kevin-nixie/mfd_thermostat/reptistat.step

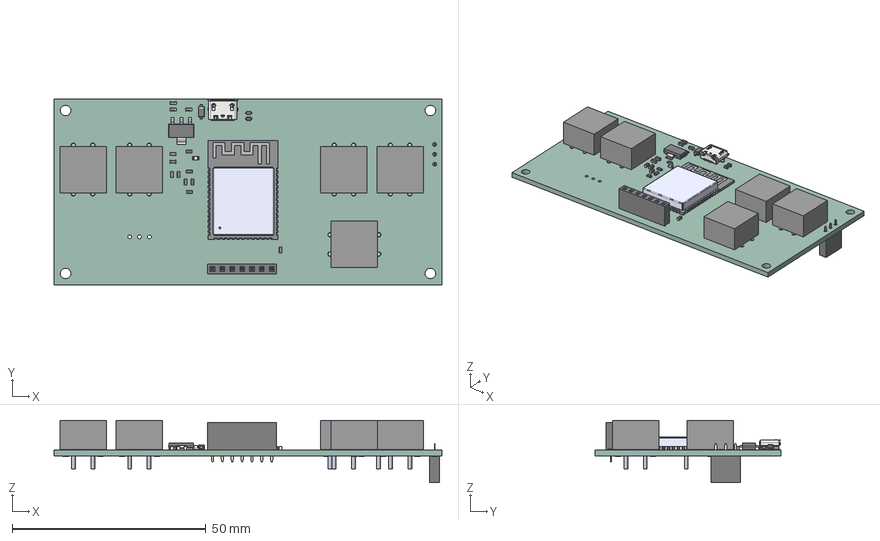
[picture p1: CAD file, 2025-11-16]
reptistat.step
100.0 x 48.0 x 16.1 mm
C_0603_1608Metric x 9
SOT_223
ASSEMBLY x 5
D_SOD_123
USB_Micro-B_Molex_47346-0001
PinSocket_1x03_P254mm_Vertical
ESP32-S3-WROOM-1-N4
PinSocket_1x07_P254mm_Vertical
D_SOD_523 x 2
R_0603_1608Metric x 4
LED_0603_1608Metric
_autosave-reptistat_PCB
