kevin-nixie/mfd_thermostat/reptistatv2a.step

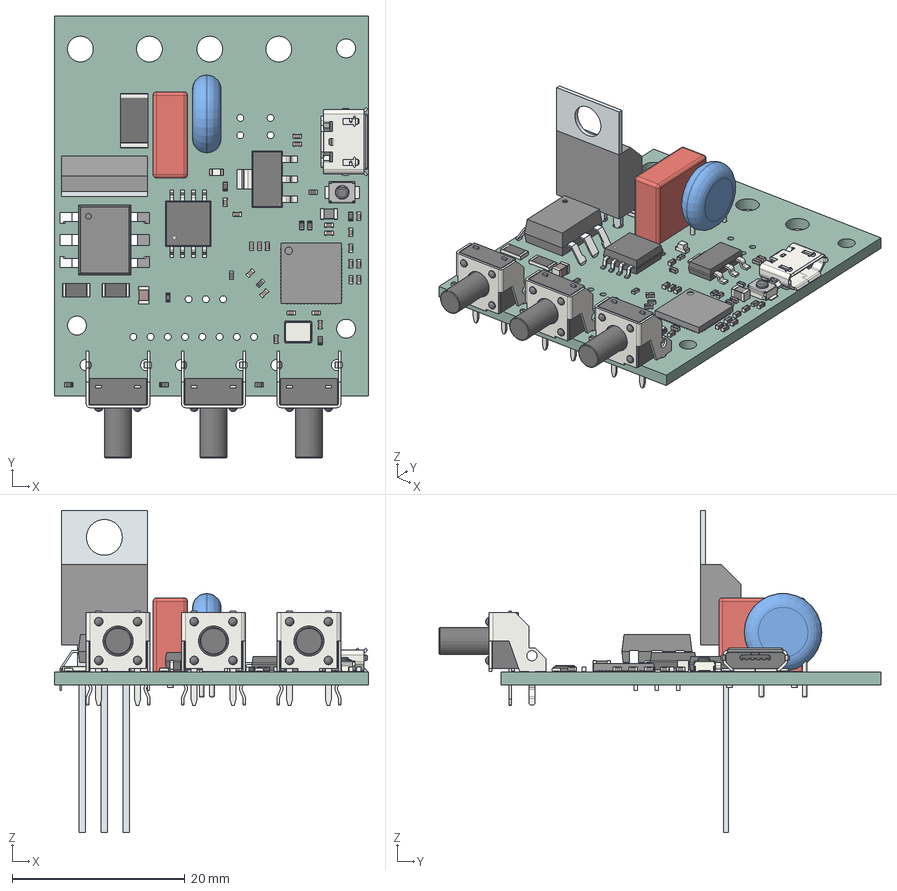
[picture p2: CAD file, 2025-11-16]
reptistatv2a.step
36.4 x 51.2 x 37.3 mm
L_0805_2012Metric
SOT-223
C_0402_1005Metric x 22
RV_Disc_D9mm_W3.3mm_P5mm
Crystal_SMD_Abracon_ABM8G-4Pin_3.2x2.5mm
R_2512_6332Metric
R_0402_1005Metric x 12
C_Rect_L10.0mm_W4.0mm_P7.50mm_FKS3_FKP3
USB_Micro-B_Molex_47346-0001
SW_Tactile_SPST_Angled_PTS645Vx83-2LFS x 3
Tab
PinsArray
SW_SPST_B3U-1000P
MOC3021SM
R_1206_3216Metric x 2
LED_0603_1608Metric
SOIC-8_5.3x5.3mm_P1.27mm
C_0805_2012Metric
ThermalPin
PinsArrayLR
PinsArrayTB
reptistat_PCB
