kevin-nixie/mfd_thermostat/reptistatV2a v1.step

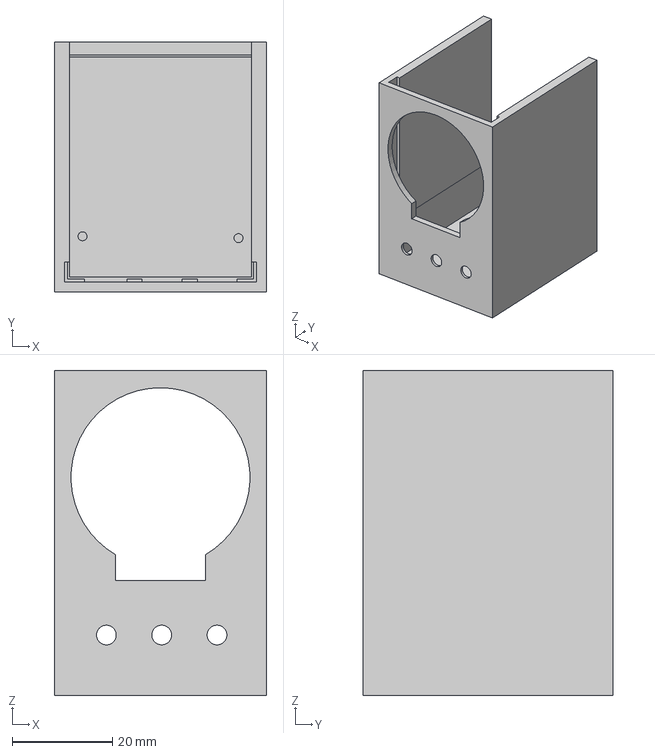
[picture p3: CAD file, 2025-11-16]
reptistatV2a v1.step
42.4 x 50.0 x 65.0 mm
