kevin-nixie/mfd_thermostat/VREG.kicad_sch

## KiCad design VREG.kicad_sch (2025-11-16)

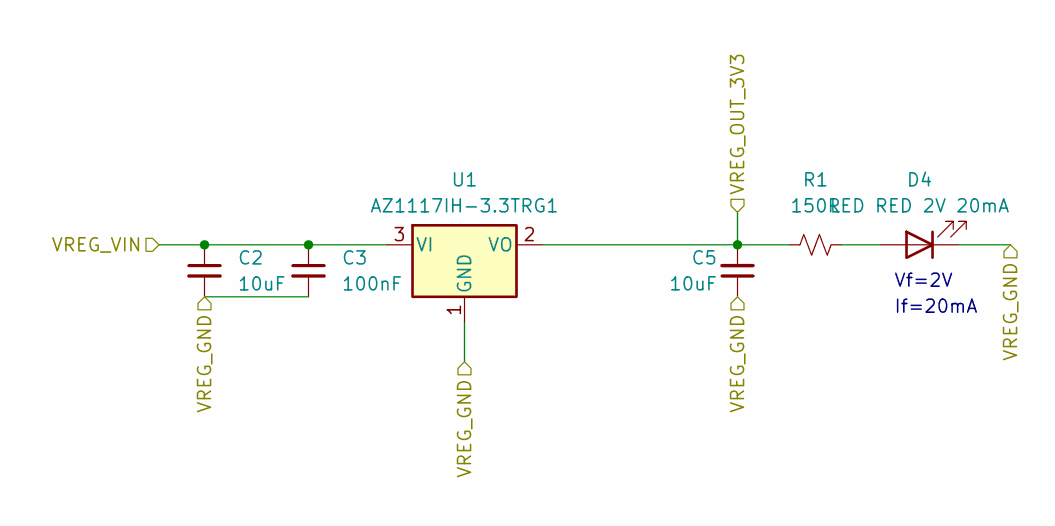
[picture p4: schematic VREG.kicad_sch]

Parts:
C2, C5: 10uF; C_0402_1005Metric; JLCPCB Part# C15525
C3: 100nF; C_0402_1005Metric; JLCPCB Part# C1525
D4: LED RED 2V 20mA; LED_0603_1608Metric; JLCPCB Part# C2286
R1: 150R; R_0402_1005Metric; JLCPCB Part# C25082
U1: AZ1117IH-3.3TRG1; SOT-223-3_TabPin2; JLCPCB Part# C108495

Connections:
unnamed: D4.2 (A), R1.2
VREG_GND: C2.2, C3.2, C5.1, D4.1 (K), U1.1 (GND)
VREG_OUT_3V3: C5.2, R1.1, U1.2 (VO)
VREG_VIN: C2.1, C3.1, U1.3 (VI)

Notes on the sheet:
Vf=2V
If=20mA
