kevin-nixie/mfd_thermostat/acdc.kicad_sch

## KiCad design acdc.kicad_sch (2025-11-16)

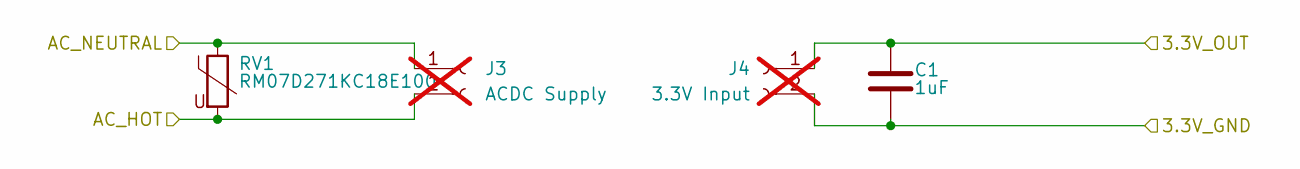
[picture p5: schematic acdc.kicad_sch]

Parts:
C1: 1uF; C_0402_1005Metric; JLCPCB Part# C52923
J3: ACDC Supply; PinHeader_1x02_P2.00mm_Vertical; not fitted
J4: 3.3V Input; PinHeader_1x02_P2.00mm_Vertical; not fitted
RV1: RM07D271KC18E100; RV_Disc_D9mm_W3.3mm_P5mm; JLCPCB Part# C2974821

Connections:
3.3V_GND: C1.2, J4.2
3.3V_OUT: C1.1, J4.1
AC_HOT: J3.2, RV1.2
AC_NEUTRAL: J3.1, RV1.1
