kevin-nixie/mfd_thermostat/connectors.kicad_sch

## KiCad design connectors.kicad_sch (2025-11-16)

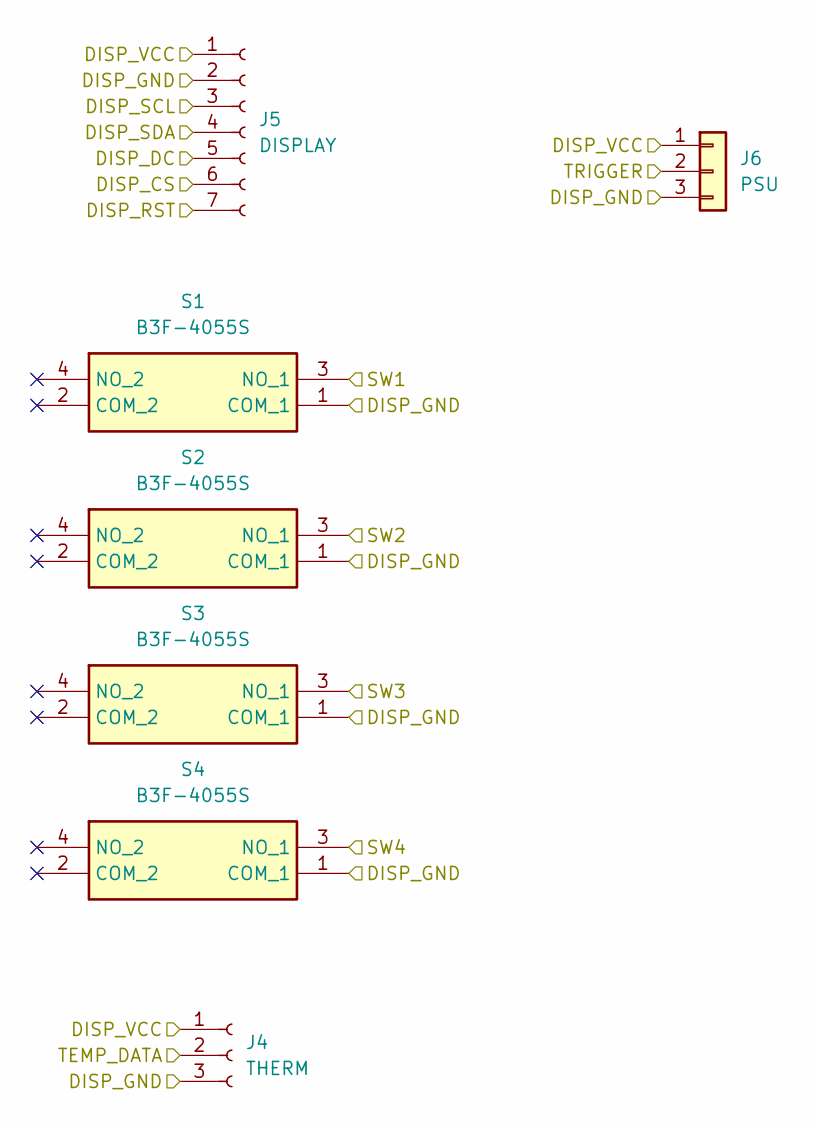
[picture p6: schematic connectors.kicad_sch]

Parts:
J4: THERM; PinHeader_1x03_P2.54mm_Vertical
J5: DISPLAY; PinHeader_1x07_P2.54mm_Vertical
J6: PSU; PinSocket_1x03_P2.54mm_Vertical
S1, S2, S3, S4: B3F-4055S; B3F4055S; Mouser Part Number 653-B3F-4055S

Connections:
DISP_CS: J5.6
DISP_DC: J5.5
DISP_GND: J4.3, J5.2, J6.3, S1.1 (COM_1), S2.1 (COM_1), S3.1 (COM_1), S4.1 (COM_1)
DISP_RST: J5.7
DISP_SCL: J5.3
DISP_SDA: J5.4
DISP_VCC: J4.1, J5.1, J6.1
SW1: S1.3 (NO_1)
SW2: S2.3 (NO_1)
SW3: S3.3 (NO_1)
SW4: S4.3 (NO_1)
TEMP_DATA: J4.2
TRIGGER: J6.2
