kevin-nixie/mfd_thermostat/mcu.kicad_sch

## KiCad design mcu.kicad_sch (2025-11-16)

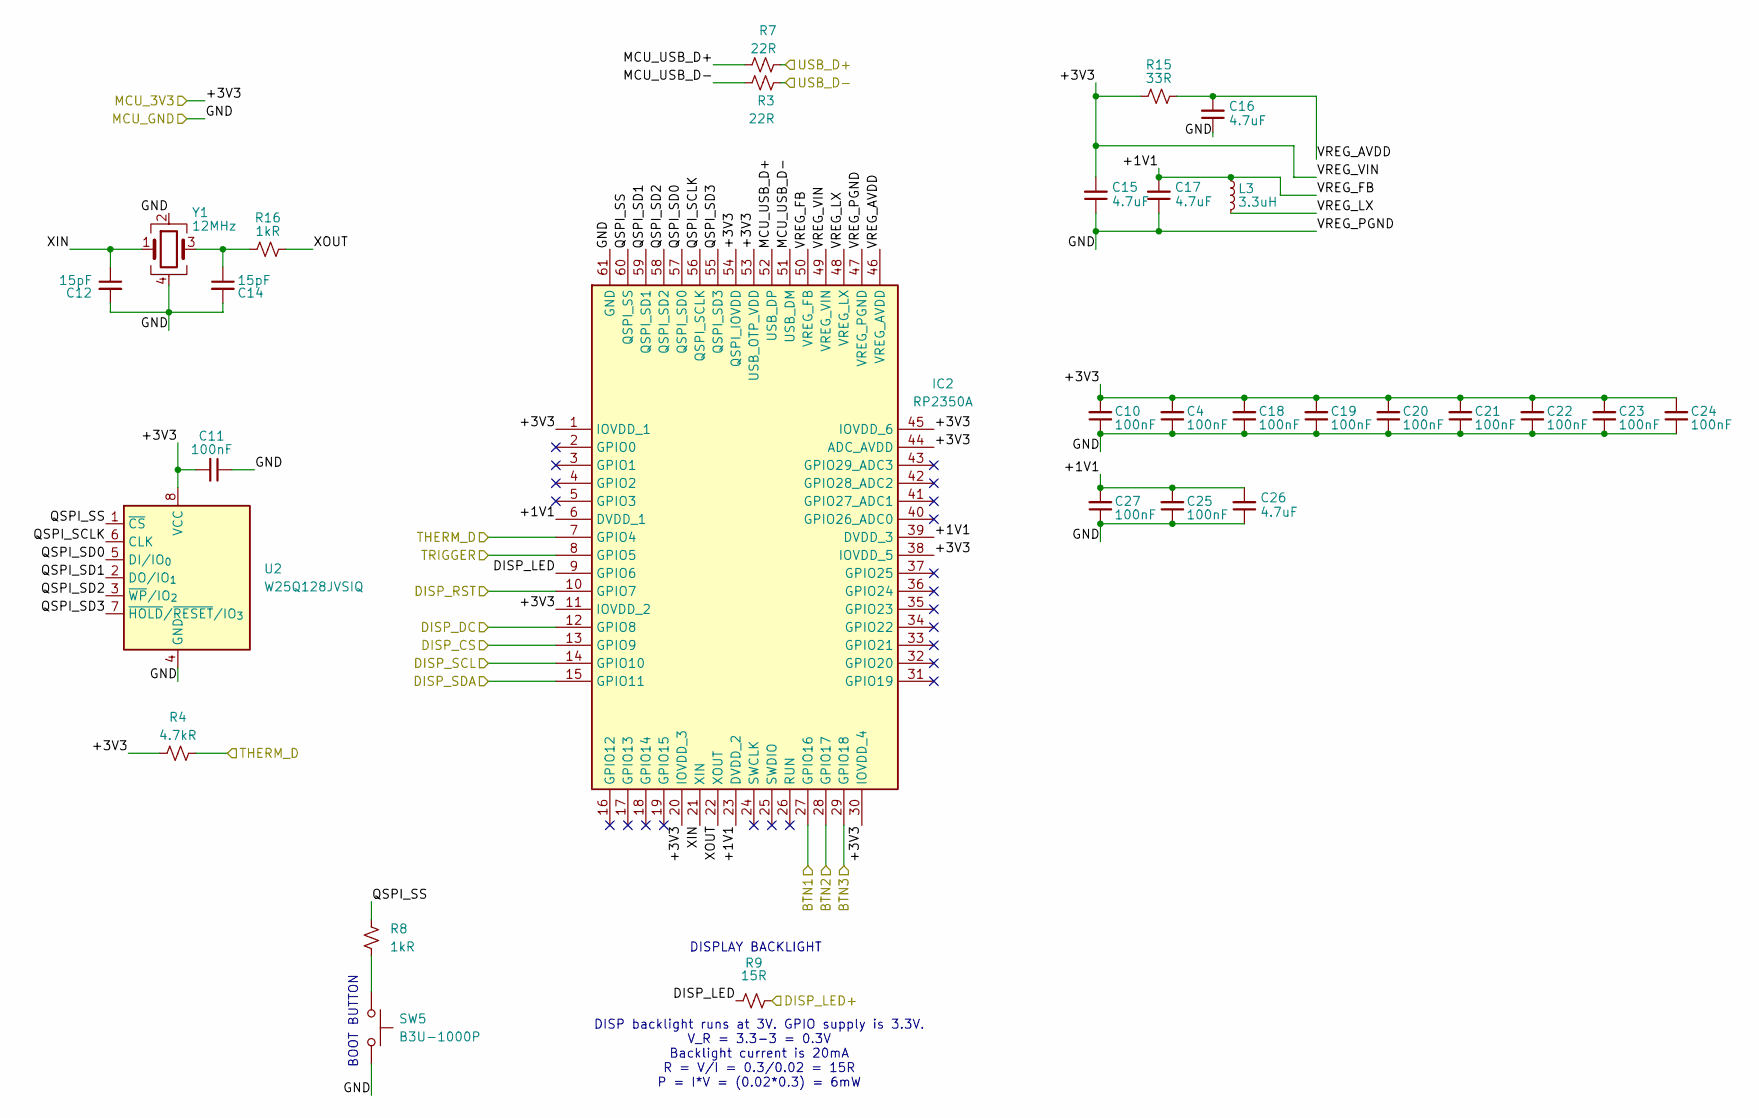
[picture p7: schematic mcu.kicad_sch]

Parts:
C4, C10, C11, C18, C19, C20, C21, C22, C23, C24, C25, C27: 100nF; C_0402_1005Metric; JLCPCB Part# C1525
C12, C14: 15pF; C_0402_1005Metric; JLCPCB Part# C1548
C15, C16, C17, C26: 4.7uF; C_0402_1005Metric; JLCPCB Part# C23733
IC2: RP2350A; JLCPCB Part# C42411118
L3: 3.3uH; L_0805_2012Metric; JLCPCB Part# C42411119
R3, R7: 22R; R_0402_1005Metric; JLCPCB Part# C25092
R4: 4.7kR; R_0402_1005Metric; JLCPCB Part# C25900
R8, R16: 1kR; R_0402_1005Metric; JLCPCB Part# C11702
R9: 15R; R_0402_1005Metric; JLCPCB Part# C25083
R15: 33R; R_0402_1005Metric; JLCPCB Part# C25105
SW5: B3U-1000P; SW_SPST_B3U-1000P; JLCPCB Part# C231329
U2: W25Q128JVSIQ; SOIC-8_5.3x5.3mm_P1.27mm; JLCPCB Part# C97521
Y1: 12MHz; Crystal_SMD_Abracon_ABM8G-4Pin_3.2x2.5mm; JLCPCB Part# C20625731

Connections:
+1V1: C17.2, C25.2, C26.2, C27.2, IC2.6 (DVDD_1), IC2.23 (DVDD_2), IC2.39 (DVDD_3), IC2.50 (VREG_FB), L3.1
+3V3: C4.2, C10.2, C11.2, C15.2, C18.2, C19.2, C20.2, C21.2, C22.2, C23.2, C24.2, IC2.1 (IOVDD_1), IC2.11 (IOVDD_2), IC2.20 (IOVDD_3), IC2.30 (IOVDD_4), IC2.38 (IOVDD_5), IC2.44 (ADC_AVDD), IC2.45 (IOVDD_6), IC2.49 (VREG_VIN), IC2.53 (USB_OTP_VDD), IC2.54 (QSPI_IOVDD), R4.1, R15.1, U2.8 (VCC)
BTN1: IC2.27 (GPIO16)
BTN2: IC2.28 (GPIO17)
BTN3: IC2.29 (GPIO18)
DISP_CS: IC2.13 (GPIO9)
DISP_DC: IC2.12 (GPIO8)
DISP_LED: IC2.9 (GPIO6), R9.2
DISP_LED+: R9.1
DISP_RST: IC2.10 (GPIO7)
DISP_SCL: IC2.14 (GPIO10)
DISP_SDA: IC2.15 (GPIO11)
GND: C4.1, C10.1, C11.1, C12.2, C14.2, C15.1, C16.1, C17.1, C18.1, C19.1, C20.1, C21.1, C22.1, C23.1, C24.1, C25.1, C26.1, C27.1, IC2.47 (VREG_PGND), IC2.61 (GND), SW5.2, U2.4 (GND), Y1.2, Y1.4
MCU_USB_D+: IC2.52 (USB_DP), R7.2
MCU_USB_D-: IC2.51 (USB_DM), R3.2
unnamed: C14.1, R16.1, Y1.3
unnamed: R8.2, SW5.1
QSPI_SCLK: IC2.56 (QSPI_SCLK), U2.6 (CLK)
QSPI_SD0: IC2.57 (QSPI_SD0), U2.5 (DI/IO_{0})
QSPI_SD1: IC2.59 (QSPI_SD1), U2.2 (DO/IO_{1})
QSPI_SD2: IC2.58 (QSPI_SD2), U2.3 (~WP/IO_{2})
QSPI_SD3: IC2.55 (QSPI_SD3), U2.7 (~HOLD/~RESET/IO_{3})
QSPI_SS: IC2.60 (QSPI_SS), R8.1, U2.1 (~CS)
THERM_D: IC2.7 (GPIO4), R4.2
TRIGGER: IC2.8 (GPIO5)
USB_D+: R7.1
USB_D-: R3.1
VREG_AVDD: C16.2, IC2.46 (VREG_AVDD), R15.2
VREG_LX: IC2.48 (VREG_LX), L3.2
XIN: C12.1, IC2.21 (XIN), Y1.1
XOUT: IC2.22 (XOUT), R16.2

Notes on the sheet:
DISP backlight runs at 3V. GPIO supply is 3.3V. V_R = 3.3-3 = 0.3V Backlight current is 20mA R = V/I = 0.3/0.02 = 15R P = I*V = (0.02*0.3) = 6mW
BOOT BUTTON
DISPLAY BACKLIGHT
