kevin-nixie/mfd_thermostat/reptistat.kicad_sch

## KiCad design reptistat.kicad_sch (2025-11-16)

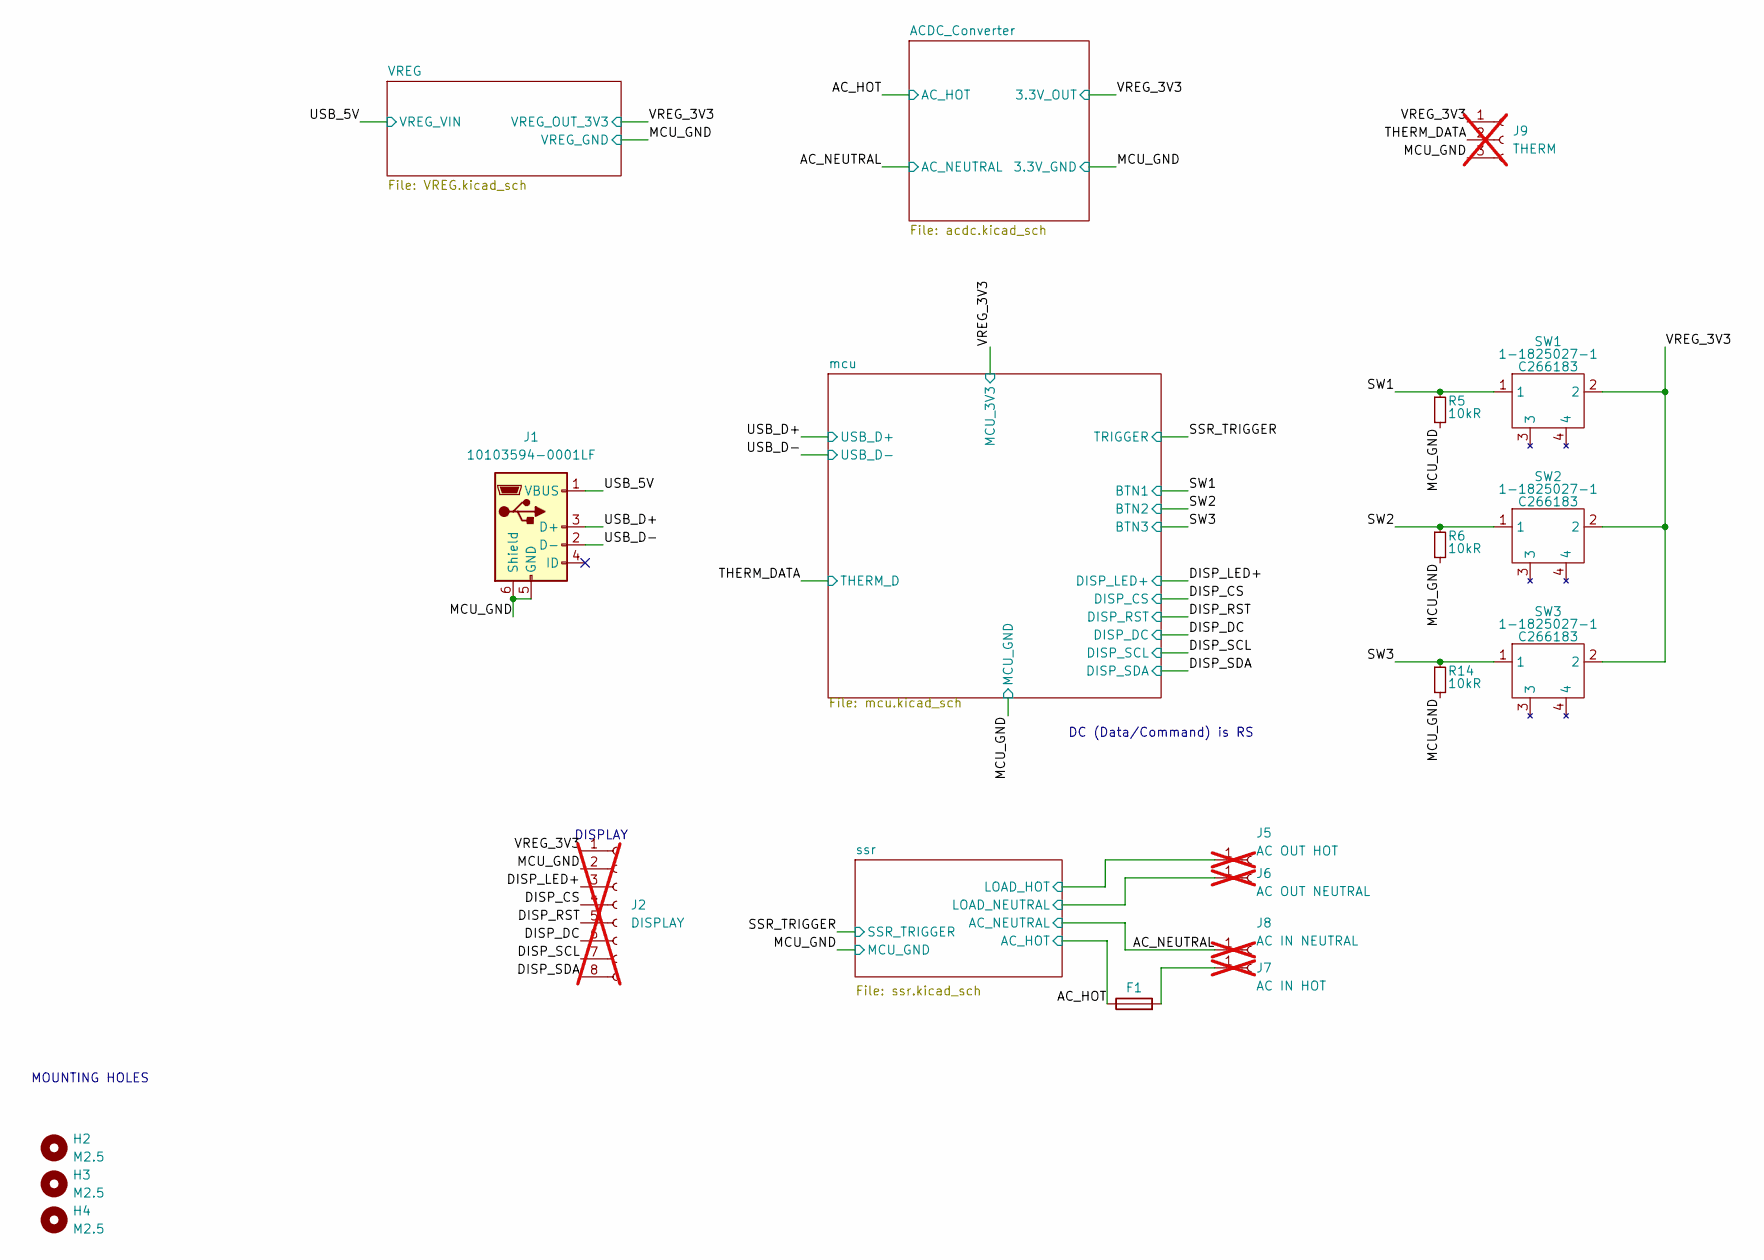
[picture p8: schematic reptistat.kicad_sch]

Parts:
F1: 3A 125V Nano2 451 Fuse; Fuse_Littelfuse-NANO2-451_453; JLCPCB Part# C13982
H2, H3, H4: M2.5; MountingHole_2.2mm_M2
J1: 10103594-0001LF; USB_Micro-B_Amphenol_10103594-0001LF_Horizontal; JLCPCB Part# C428495
J2: DISPLAY; PinHeader_1x08_P2.00mm_Vertical; not fitted
J5: AC OUT HOT; TestPoint_Plated_Hole_D3.0mm; not fitted
J6: AC OUT NEUTRAL; TestPoint_Plated_Hole_D3.0mm; not fitted
J7: AC IN HOT; TestPoint_Plated_Hole_D3.0mm; not fitted
J8: AC IN NEUTRAL; TestPoint_Plated_Hole_D3.0mm; not fitted
J9: THERM; PinHeader_1x03_P2.00mm_Vertical; not fitted
R5, R6, R14: 10kR; R_0402_1005Metric; JLCPCB Part# C25744
SW1, SW2, SW3: 1-1825027-1; JLCPCB Part# C266183

Connections:
AC_HOT: F1.1
AC_NEUTRAL: J8.1
DISP_CS: J2.4
DISP_DC: J2.6
DISP_LED+: J2.3
DISP_RST: J2.5
DISP_SCL: J2.7
DISP_SDA: J2.8
LOAD_HOT: J5.1
LOAD_NEUTRAL: J6.1
MCU_GND: J1.5 (GND), J1.6 (Shield), J2.2, J9.3, R5.2, R6.2, R14.2
unnamed: F1.2, J7.1
SW1: R5.1, SW1.1
SW2: R6.1, SW2.1
SW3: R14.1, SW3.1
THERM_DATA: J9.2
USB_5V: J1.1 (VBUS)
USB_D+: J1.3 (D+)
USB_D-: J1.2 (D-)
VREG_3V3: J2.1, J9.1, SW1.2, SW2.2, SW3.2

Notes on the sheet:
MOUNTING HOLES
DISPLAY
DC (Data/Command) is RS
