kevin-nixie/mfd_thermostat/ssr.kicad_sch

## KiCad design ssr.kicad_sch (2025-11-16)

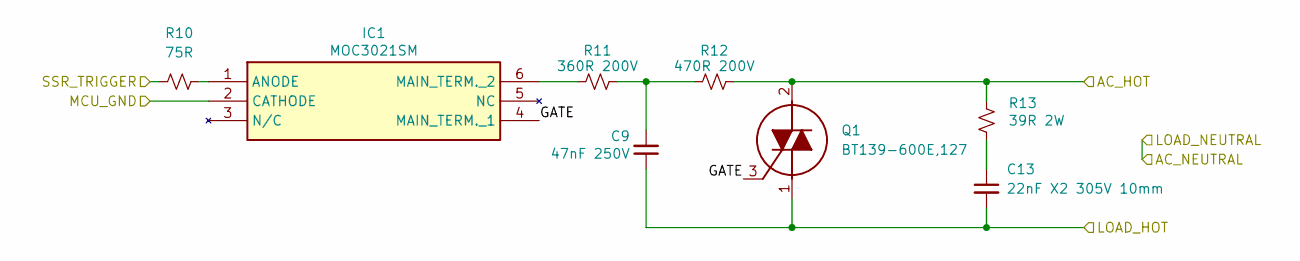
[picture p9: schematic ssr.kicad_sch]

Parts:
C9: 47nF 250V; C_0805_2012Metric; JLCPCB Part# C7393958
C13: 22nF X2 305V 10mm; C_Rect_L10.0mm_W4.0mm_P7.50mm_FKS3_FKP3; JLCPCB Part# C2693739
IC1: MOC3021SM; SOP254P916X480-6N; JLCPCB Part# C108500
Q1: BT139-600E,127; TO254P470X1000X2000-3P; JLCPCB Part# C389357
R10: 75R; R_0402_1005Metric; JLCPCB Part# C25133
R11: 360R 200V; R_1206_3216Metric; JLCPCB Part# C17932
R12: 470R 200V; R_1206_3216Metric; JLCPCB Part# C4502
R13: 39R 2W; R_2512_6332Metric; JLCPCB Part# C7337035

Connections:
AC_HOT: Q1.2 (MT2), R12.2, R13.1
GATE: IC1.4 (MAIN_TERM._1), Q1.3 (G)
LOAD_HOT: C9.1, C13.2, Q1.1 (MT1)
MCU_GND: IC1.2 (CATHODE)
unnamed: C9.2, R11.2, R12.1
unnamed: C13.1, R13.2
unnamed: IC1.1 (ANODE), R10.2
unnamed: IC1.6 (MAIN_TERM._2), R11.1
SSR_TRIGGER: R10.1
