kevin-nixie/mfd_thermostat/(commit log)

2025-11-16 v2a. Ordered and tested
    [VREG.kicad_sch, acdc.kicad_sch, connectors.kicad_sch, mcu.kicad_sch, reptistat.kicad_pcb, reptistat.kicad_sch, reptistat.step, reptistatV2a v1.step]
2025-11-16 remove redundant reptistat folder
    [VREG.kicad_sch, acdc.kicad_sch, connectors.kicad_sch, mcu.kicad_sch, reptistat.kicad_pcb, reptistat.kicad_sch, reptistat.step, reptistatV2a v1.step]
